gravitymir/drain_watcher/hardware/README.md

# drain_watcher: плата v3

Логгер тока утечки автомобильного аккумулятора: ESP32-S3 и INA228 на одной плате. Питается
от того же аккумулятора через понижающий преобразователь, Wi-Fi поднимает сама: история
замеров смотрится с телефона или ноутбука через веб-страницу, без проводов к машине.

Шунт стоит на силовых шинах в минусе аккумулятора, **основной ток по плате не идёт**: она
только снимает напряжение с шунта (четырёхпроводное подключение, Kelvin) и напряжение
аккумулятора.

| | |
|---|---|
| Размер | 52 × 41.2 мм, без крепёжных отверстий, 2 слоя, 1.6 мм, медь 1 oz |
| Контроллер | ESP32-S3-WROOM-1-N8R2 (металлический экран, до +85 °C), антенна у левого края |
| Измерение | INA228 (20 бит, смещение ±1 мкВ), I2C, адрес **0x40** (A0 = A1 = GND) |
| Звук | I2S-микрофон ICS-43434, моно |
| Питание | BAT+ 6…24 В (AP63205, 5 В) **или** USB-C 5 В; 3.3 В — TLV75733 |
| Проверки | DRC KiCad 10: 0 нарушений на всех уровнях, схема = плата; ERC: 0 сообщений |

## Провода J2 — к шунту и аккумулятору

Четыре отверстия 1.15 мм под провод до 0.5 мм², шаг 4.6 мм. Провода впаиваются наглухо.

| Контакт | Цепь | Куда |
|---|---|---|
| 1 `SNS+` | SNS_P | измерительный винт шунта со стороны **кузова** (отдельный тонкий провод) |
| 2 `SNS-` | SNS_N | измерительный винт шунта со стороны **аккумулятора** (отдельный тонкий провод) |
| 3 `GND` | GND | та же сторона шунта, что и SNS-, но **своим** проводом |
| 4 `BAT+` | VBAT | плюс аккумулятора через **предохранитель 1 А в самом проводе** |

SNS+ и SNS- скрутите в пару и заведите прямо на измерительные винты шунта. Положительный
ток означает разряд. BAT+ теперь и питает плату (ESP32 с Wi-Fi — в среднем ~40 мА от 12 В,
пики ~150 мА), и даёт INA228 напряжение аккумулятора.

## Выводы ESP32

| Сигнал | GPIO | Вывод модуля |
|---|---|---|
| I2C SDA (INA228) | IO13 | 21 |
| I2C SCL (INA228) | IO12 | 20 |
| ALERT INA228 | IO21 | 23 — подтяжки на плате нет, включите внутреннюю |
| RGB-светодиод WS2812B (DIN) | IO48 | 25 — как на DevKitC-1 |
| Кнопка BOOT | IO0 | 27 |
| USB D-/D+ | IO19/IO20 | 13/14 — встроенный USB Serial/JTAG: прошивка и логи |
| Микрофон I2S SD | IO47 | 24 — данные, подтяжка 100 кОм на землю (R12) на плате |
| Микрофон I2S WS | IO14 | 22 |
| Микрофон I2S SCK | IO11 | 19 |

Подтяжки I2C 4.7 кОм к 3.3 В стоят на плате.

### Микрофон

**MK1 — ICS-43434** (I2S MEMS, как в Voice-Unit) в середине верхней части, над INA228.
Развязка C11 100 нФ вплотную к выводу VDD. R12 100 кОм держит линию SD на земле, пока
микрофон её отпускает (так требует даташит).
Вывод L/R на земле — левый канал, моно. Звуковой порт у него снизу: под корпусом в плате
отверстие 0.5 мм, звук заходит с **обратной стороны** — в корпусе напротив него нужно
отверстие. В прошивке: I2S, 24 бита в 32-битном слове, левый канал, частота до 48 кГц.

### Ряд отверстий GPIO (J3, шаг 2.54 мм)

Над модулем, слева направо (подписи с обеих сторон):

`IO1 IO2 TX RX IO42 IO41 IO40 IO39 IO38 IO37 IO36 IO35 GND 3V3 5V`

Это все свободные выводы верхнего ряда модуля в том же порядке, что и у самого модуля.
IO35–IO37 свободны только у модулей **без восьмибитной PSRAM** (N8, N8R2). У N16R8 они
заняты памятью, поэтому такой модуль сюда не ставить. `5V` — общая шина после диодов
«ИЛИ» (~4.6 В), `3V3` — выход стабилизатора, от каждого можно взять до ~200 мА.

## Питание

```
BAT+ ─ D4 (B5819W) ─┬─ D5 SMF24A, C10 10 мкФ ─ U3 AP63205 ─ L1 4.7 мкГн ─ C13,C14 2×22 мкФ ─ D6 ─┐
                    (VIN, до 32 В)                                       (+5V_B)                ├─ +5V ─ U4 TLV75733 ─ +3V3
USB VBUS ────────────────────────────────────────────────────────────────────────── D7 ────────┘
```

- **D4** — защита от переполюсовки BAT+ (Шоттки, теряется ~0.4 В).
- **D5** — TVS 24 В от выбросов на входе. Машина при замерах не заводится, выше 14.4 В
  напряжение не поднимается, запас до предела AP63205 (32 В) большой.
- **D6, D7** — диоды «ИЛИ»: плата одинаково работает от аккумулятора, от USB или от
  обоих сразу, и USB-порт компьютера не получает напряжение с преобразователя.
- **USB-C** — для прошивки и логов. Подключённый к машине, компьютер оказывается
  соединённым с кузовом через GND. Ноутбук на батарее — нормально, компьютер от сети —
  нет (или через USB-изолятор).

## Шунт

Плата рассчитана на замеры **на заглушённой машине**: двигатель не запускается, машина не
едет. Тогда весь ток — это блоки, свет и вентиляторы, максимум ~20–25 А, с запасом **35 А**.

| | |
|---|---|
| Шунт | четырёхвыводной, **30 А / 75 мВ = 2.5 мОм** (например CG FL-2C 30A 75mV, класс 0.5) |
| Шкала | широкий диапазон ±163.84 мВ — до ~65 А; узкий ±40.96 мВ — до ~16 А с шагом ~31 мкА |
| Точность на утечке | ±0.4 мА по смещению INA228, после калибровки нуля — порядка ±0.05–0.1 мА |

**Запуск двигателя через шунт на 2.5 мОм недопустим**: 150–300 А его сожгут, а сгоревший в
обрыв шунт оставит машину без основной массы. Поставьте **параллельно шунту выключатель
массы** на 100–300 А: замкнут — шунт закорочен, машина ездит как обычно; разомкнут — идёт
замер.

## Измерение: два диапазона и калибровка

У INA228 полная шкала по шунту переключается битом **`ADCRANGE`** в регистре `CONFIG`.
Те же 20 бит ложатся на вчетверо меньший диапазон, то есть шаг становится вчетверо мельче:

| `ADCRANGE` | полная шкала | шаг по напряжению | на шунте 2.5 мОм |
|---|---|---|---|
| 0 — широкий | ±163.84 мВ | 312.5 нВ | до ±65 А, шаг 125 мкА |
| 1 — узкий | ±40.96 мВ | 78.125 нВ | до ±16 А, **шаг 31 мкА** |

Ток утечки — десятки миллиампер: 30 мА на 2.5 мОм дают 75 мкВ, то есть почти тысячу
отсчётов на узкой шкале и всего две с половиной сотни на широкой. Поэтому спящая машина
меряется узким диапазоном, а широкий нужен, только когда какой-то блок проснулся и утянул
больше ~16 А.

**При смене диапазона обязательно пересчитывается `SHUNT_CAL`.** Он считается как
`13107.2e6 × CURRENT_LSB × R_шунта`, и для узкого диапазона результат **умножается на 4**.
В драйвере [`firmware/ina228`](../firmware/ina228) диапазон меняется только через
`set_range`, который сразу переписывает и `SHUNT_CAL`, а `measure_autoranged` сам уходит в
широкую шкалу при переполнении узкой и возвращается, когда ток опустится ниже 80 % узкой.

**Параметры для прошивки:** `R_SHUNT = 0.0025` Ом, верх шкалы 35 А, отсюда
`CURRENT_LSB = 35 / 2¹⁹ ≈ 66.8 мкА`. Один раз — калибровка нуля (замкнуть SNS+ и SNS− и
запомнить смещение) и коэффициента (сверка с мультиметром или токовыми клещами). Делитель
VBUS занижает напряжение примерно на 1 % — тоже калибровочный коэффициент.

## Вход измерения

- **Ток**: TVS SMF24CA (двунаправленный) на проводах, затем по 10 Ом в каждую линию и
  100 нФ между входами у INA228 (как в TI, раздел 8.1).
- **Напряжение АКБ**: 10 кОм (1206) → SMF24A на землю + 100 нФ → VBUS INA228.
- **TVS на входе 24 В, а не ±5 В.** Входы INA228 выдерживают ±40 В дифференциально и
  85 В синфазно, ток в вывод — до 5 мА. TVS на 5 В при случайном касании SNS+ к +12 В
  открылся бы и замкнул аккумулятор через провод. SMF24CA при 12 В закрыт.
- **VBUS через 10 кОм** ограничивает ток при переполюсовке до 1.2 мА (меньше 5 мА).

## Заказ

JLCPCB, три файла из этой папки:

1. **`drain_watcher_gerbers.zip`** — плата. 2 слоя, FR-4, 1.6 мм, медь 1 oz, остальное по
   умолчанию. Дорожки от 0.15 мм (у падов USB-C — 0.13 мм), зазоры 0.2 мм, отверстия от 0.3 мм, via 0.6/0.3 — всё в
   стандартных нормах для двухслойки.
2. **`BOM.csv`** — 38 SMD-деталей, номера LCSC проставлены. ESP32-S3, INA228, AP63205,
   TLV75733, WS2812B, ICS-43434, B5819W, дроссель, USB-C, кнопки и TVS — Extended (разовая плата за
   установку каждой позиции), пассивка — Basic. **Наличие проверьте при заказе**: INA228
   сейчас в дефиците (см. ниже).
3. **`pos.csv`** — координаты для монтажа (только верхняя сторона).

В просмотрщике размещения у JLCPCB проверьте:
- **U1** (модуль) — антенна к левому краю платы, за контур;
- **U2, U3, U4** — точка/ключ первого вывода — как на шелкографии;
- **D4, D6, D7, D2, D5** — полоска катода как на шелкографии;
- **D3** (WS2812B) — скошенный угол/метка 1-го вывода как на шелкографии.

Поправки для JLCPCB уже внесены в `pos.csv` (`ROT_FIX` и `POS_FIX` в `gen/export.py`):
U2, U3, U4 и микрофон MK1 — +270°, у них корпус в библиотеке EasyEDA лежит поперёк; модуль U1 — +3.62 мм
по X, у EasyEDA начало координат модуля в центре падов; USB-C J1 — 1.57 мм по Y.
Проверка — `gen/jlc_check.py`: она скачивает посадочные места JLCPCB по номерам LCSC и
сравнивает их пады с нашими (`~` у кнопок, D1 и центрального пада модуля — норма).

J2 (провода) и J3 (ряд GPIO) — только отверстия: в BOM и CPL их нет.

**ICS-43434** (C5656610) снят с производства, остатки на складе небольшие. Если его не
окажется — «Do not place» и запаять руками (корпус LGA 3.5 × 2.65 мм, только феном).

**INA228** у JLCPCB/LCSC, DigiKey и Mouser сейчас нет (ожидается в 2027). Вариант —
выпаять из модулей Adafruit 5832 и поставить руками (MSOP-10), а в BOM исключить U2.
По выводам совместим INA226 (16 бит, шкала ±81.92 мВ) — подходит как временная замена.

## Сборка из скриптов

Плату не рисовали мышкой: схему, размещение, ручную разводку критичных цепей и шелк
описывает `gen/build.py`, остальное разводит Freerouting через `gen/route.py`, после чего
углы скругляются дугами. Нужен Python из KiCad 10, а для перетрассировки — Java 21+ и
[Freerouting 2.5](https://github.com/freerouting/freerouting/releases) (переменные
`JAVA` и `FREEROUTING_JAR`, по умолчанию `~/tools/jre/*/bin/java` и
`~/tools/freerouting/freerouting-2.5.0.jar`).

```bash
sh gen/check.sh
```

Скрипт пересобирает схему и плату, разводит её и прогоняет DRC KiCad с проверкой схемы
против платы, ERC, зазоры, связность, courtyard и шелк. Выходные файлы для заказа:

```bash
"/c/Program Files/KiCad/10.0/bin/python.exe" gen/outputs.py drain_watcher.kicad_pcb
"/c/Program Files/KiCad/10.0/bin/python.exe" gen/export.py .
```

### Как устроена разводка

- **Вручную** (`build.py`, заблокирована): Kelvin-пара от проводов через RC-фильтр к
  INA228, VBUS INA228, земля адреса, BAT+ → D4, via на землю у силовой части.
- **Freerouting** (`route.py`): всё остальное, только углы 45°, питание 0.4–0.5 мм, USB
  0.15 мм. У узких падов USB-C роутер сам сужает дорожку, `route.py` доводит такие места
  до 0.13 мм (норма JLCPCB для двухслойки — от 0.127). Результат (`drain_watcher.ses`) лежит в репозитории вместе с ключом
  (`.ses.key`). Пока не менялись детали, их места и ручная разводка, роутер не
  запускается, плата собирается из готового `.ses` одинаково. `--reroute` — развести
  заново.
- **Правило проекта** `drain_watcher.kicad_dru`: мелким земляным падам со своей
  дорожкой на via (адрес INA228, земля микрофона) хватает одной тепловой перемычки к
  заливке.
- **Дуги**: каждый излом заменяется дугой радиусом до 1 мм; если дуга подошла к
  соседу ближе зазора, она откатывается обратно в излом.
- Freerouting от раза к разу разводит по-разному. Если DRC KiCad результат не
  пропускает, `route.py` разводит заново (до 8 попыток).

Версии без контроллера (модуль INA228 под внешний ESP32) и прошлые варианты с ESP32
остались в истории git.
