gravitymir/drain_watcher/hardware/bot.pdf

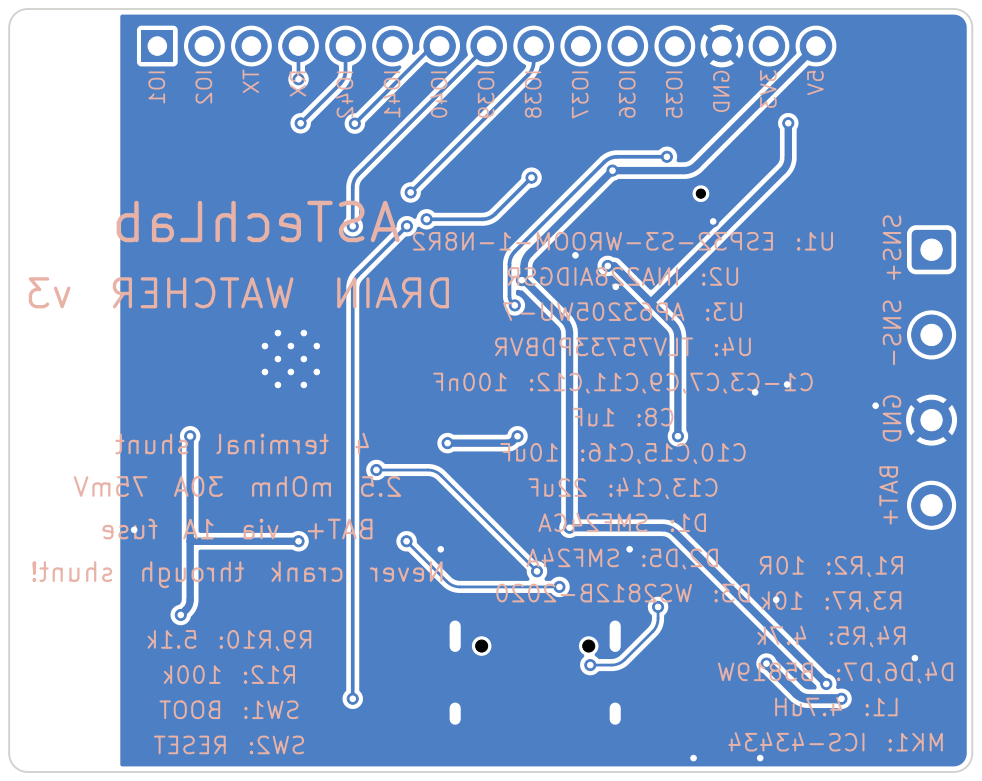
[picture p1: page 1]

IO1 IO2 TXRXIO42 IO41 IO40 IO39 IO38 IO37 IO36 IO35 GND 3V3 5V 5.1k R9,R10: 100k R12: BOOT SW1: RESET SW2: ESP32-S3-WROOM-1-N8R2 U1:

ICS-43434 MK1: BAT+ SNS+ SNS- GND

fuse 1A via BAT+ shunt! through crank Never v3 WATCHER DRAIN
