gravitymir/drain_watcher/hardware/sch.pdf

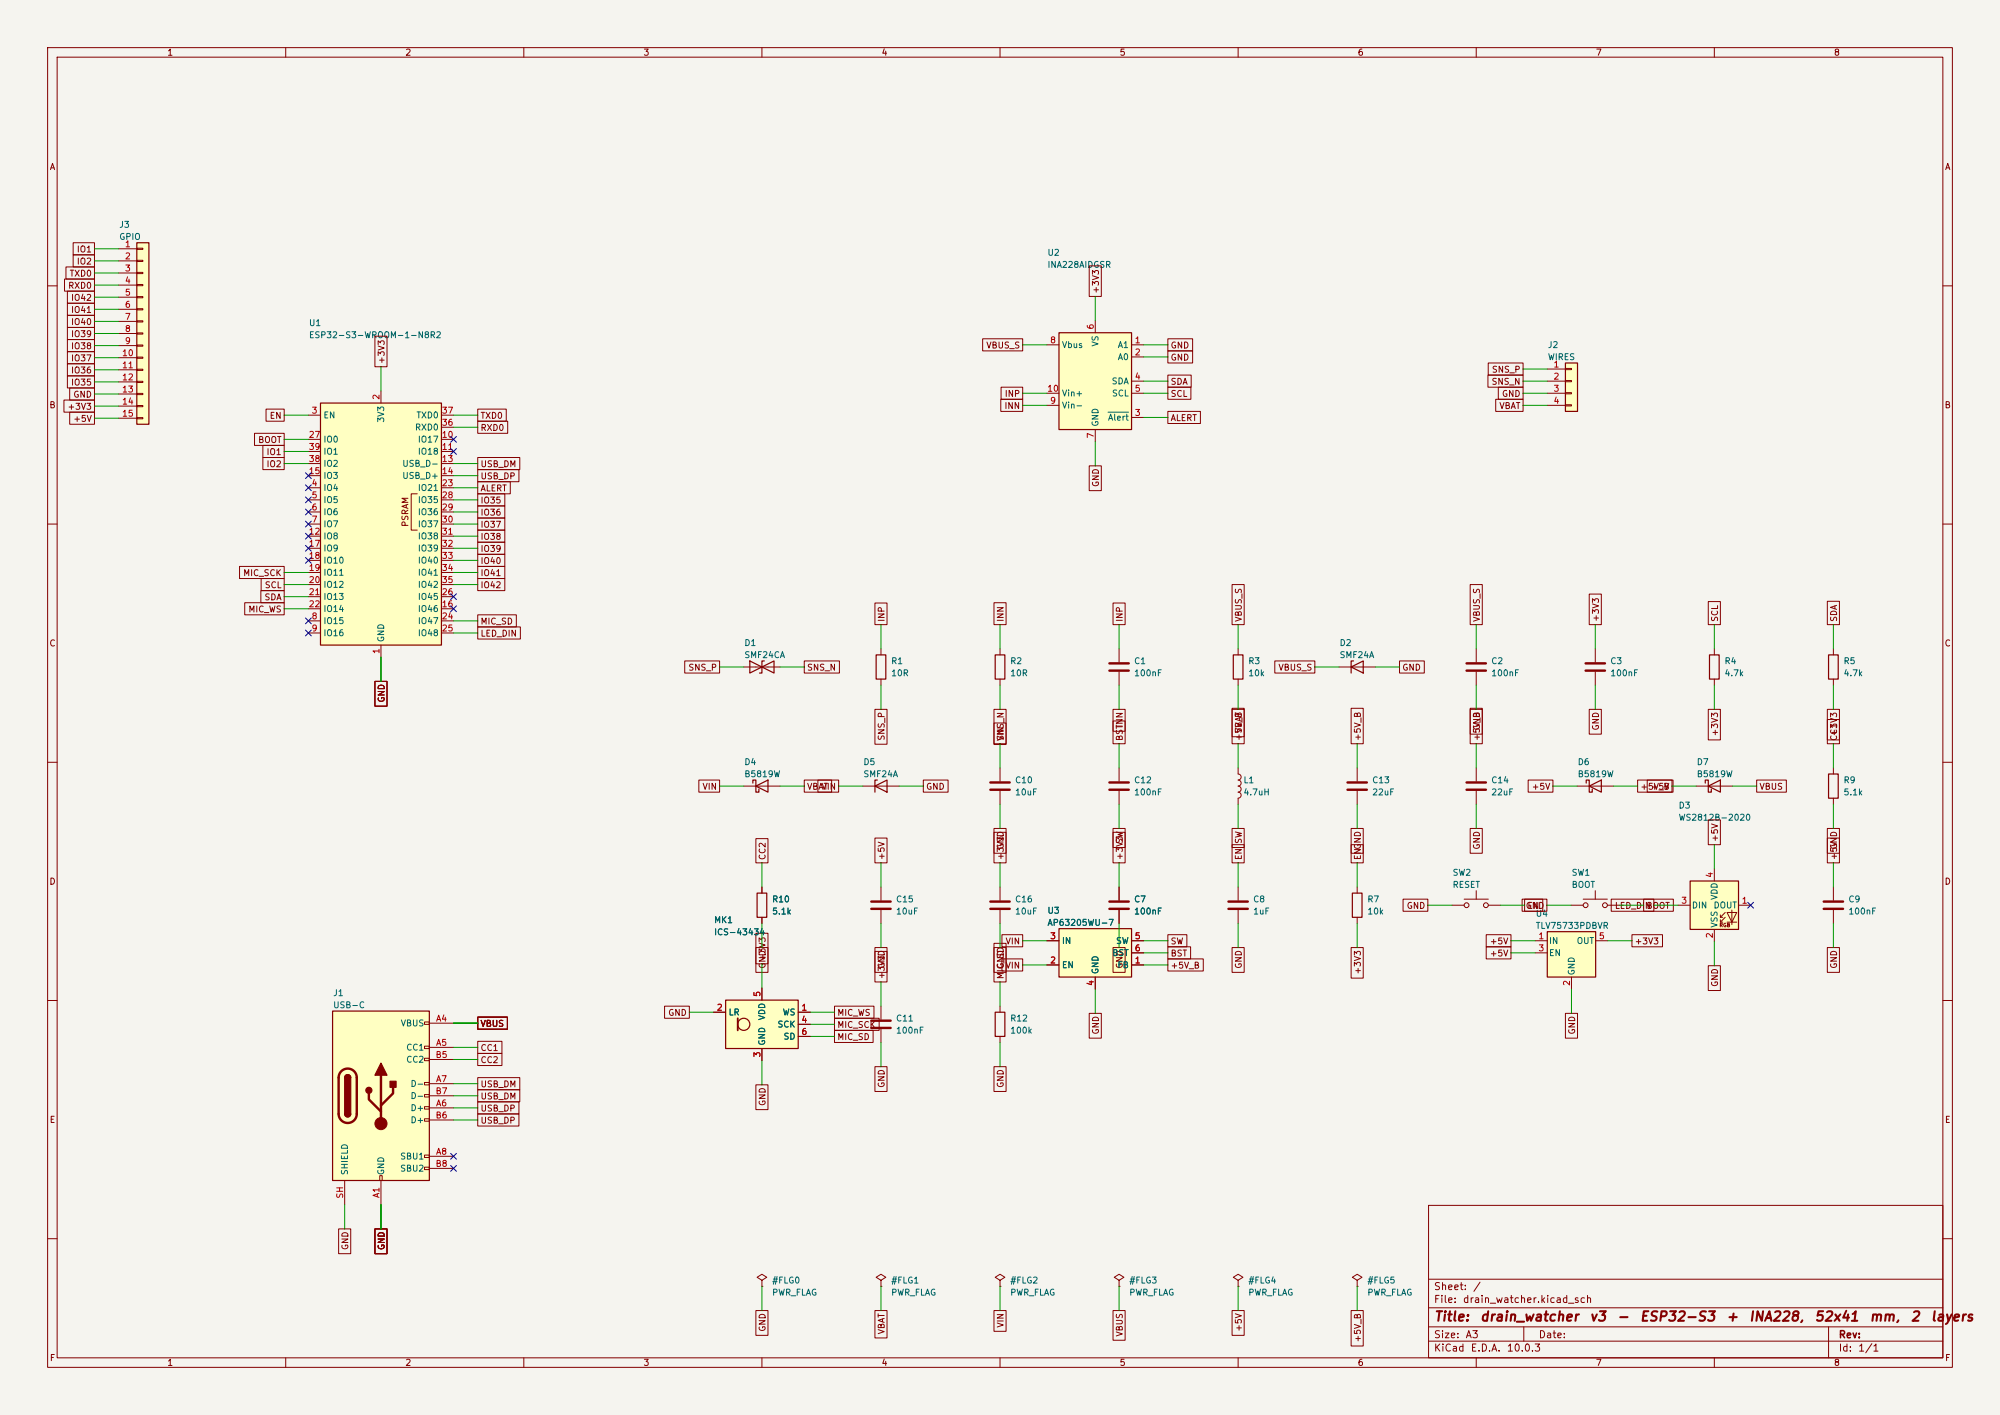
[picture p2: page 1]

Size: A3 | Rev: | F Date:
KiCad E.D.A. 10.0.3 | Id: 1/1
