gravitymir/drain_watcher/hardware/top.pdf

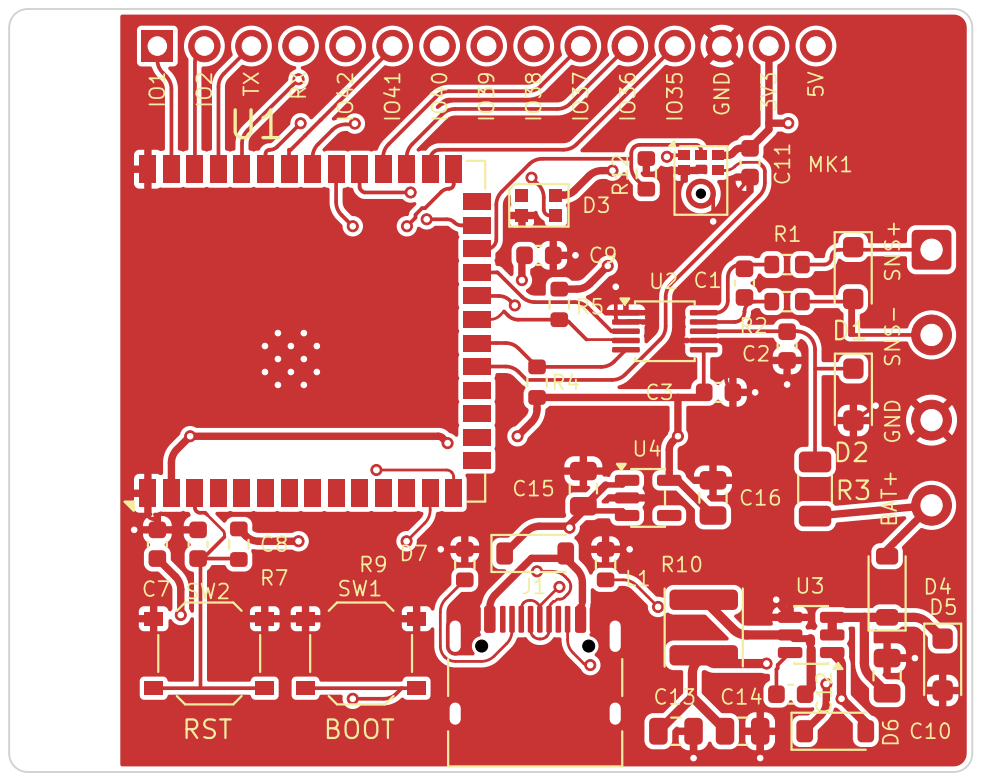
[picture p3: page 1]

IO1 IO2TXRX IO42 IO41 IO40 IO39 IO38 IO37 IO36 IO35 GND 3V35V BAT+ SNS+ SNS- GND RST BOOT U2 D3 C8 R2 R9 R7 D4 C14 D5 C15 R12
