gravitymir/drain_watcher/hardware/drain_watcher.kicad_pcb

## KiCad design hardware/drain_watcher.kicad_pcb (2026-11-14)

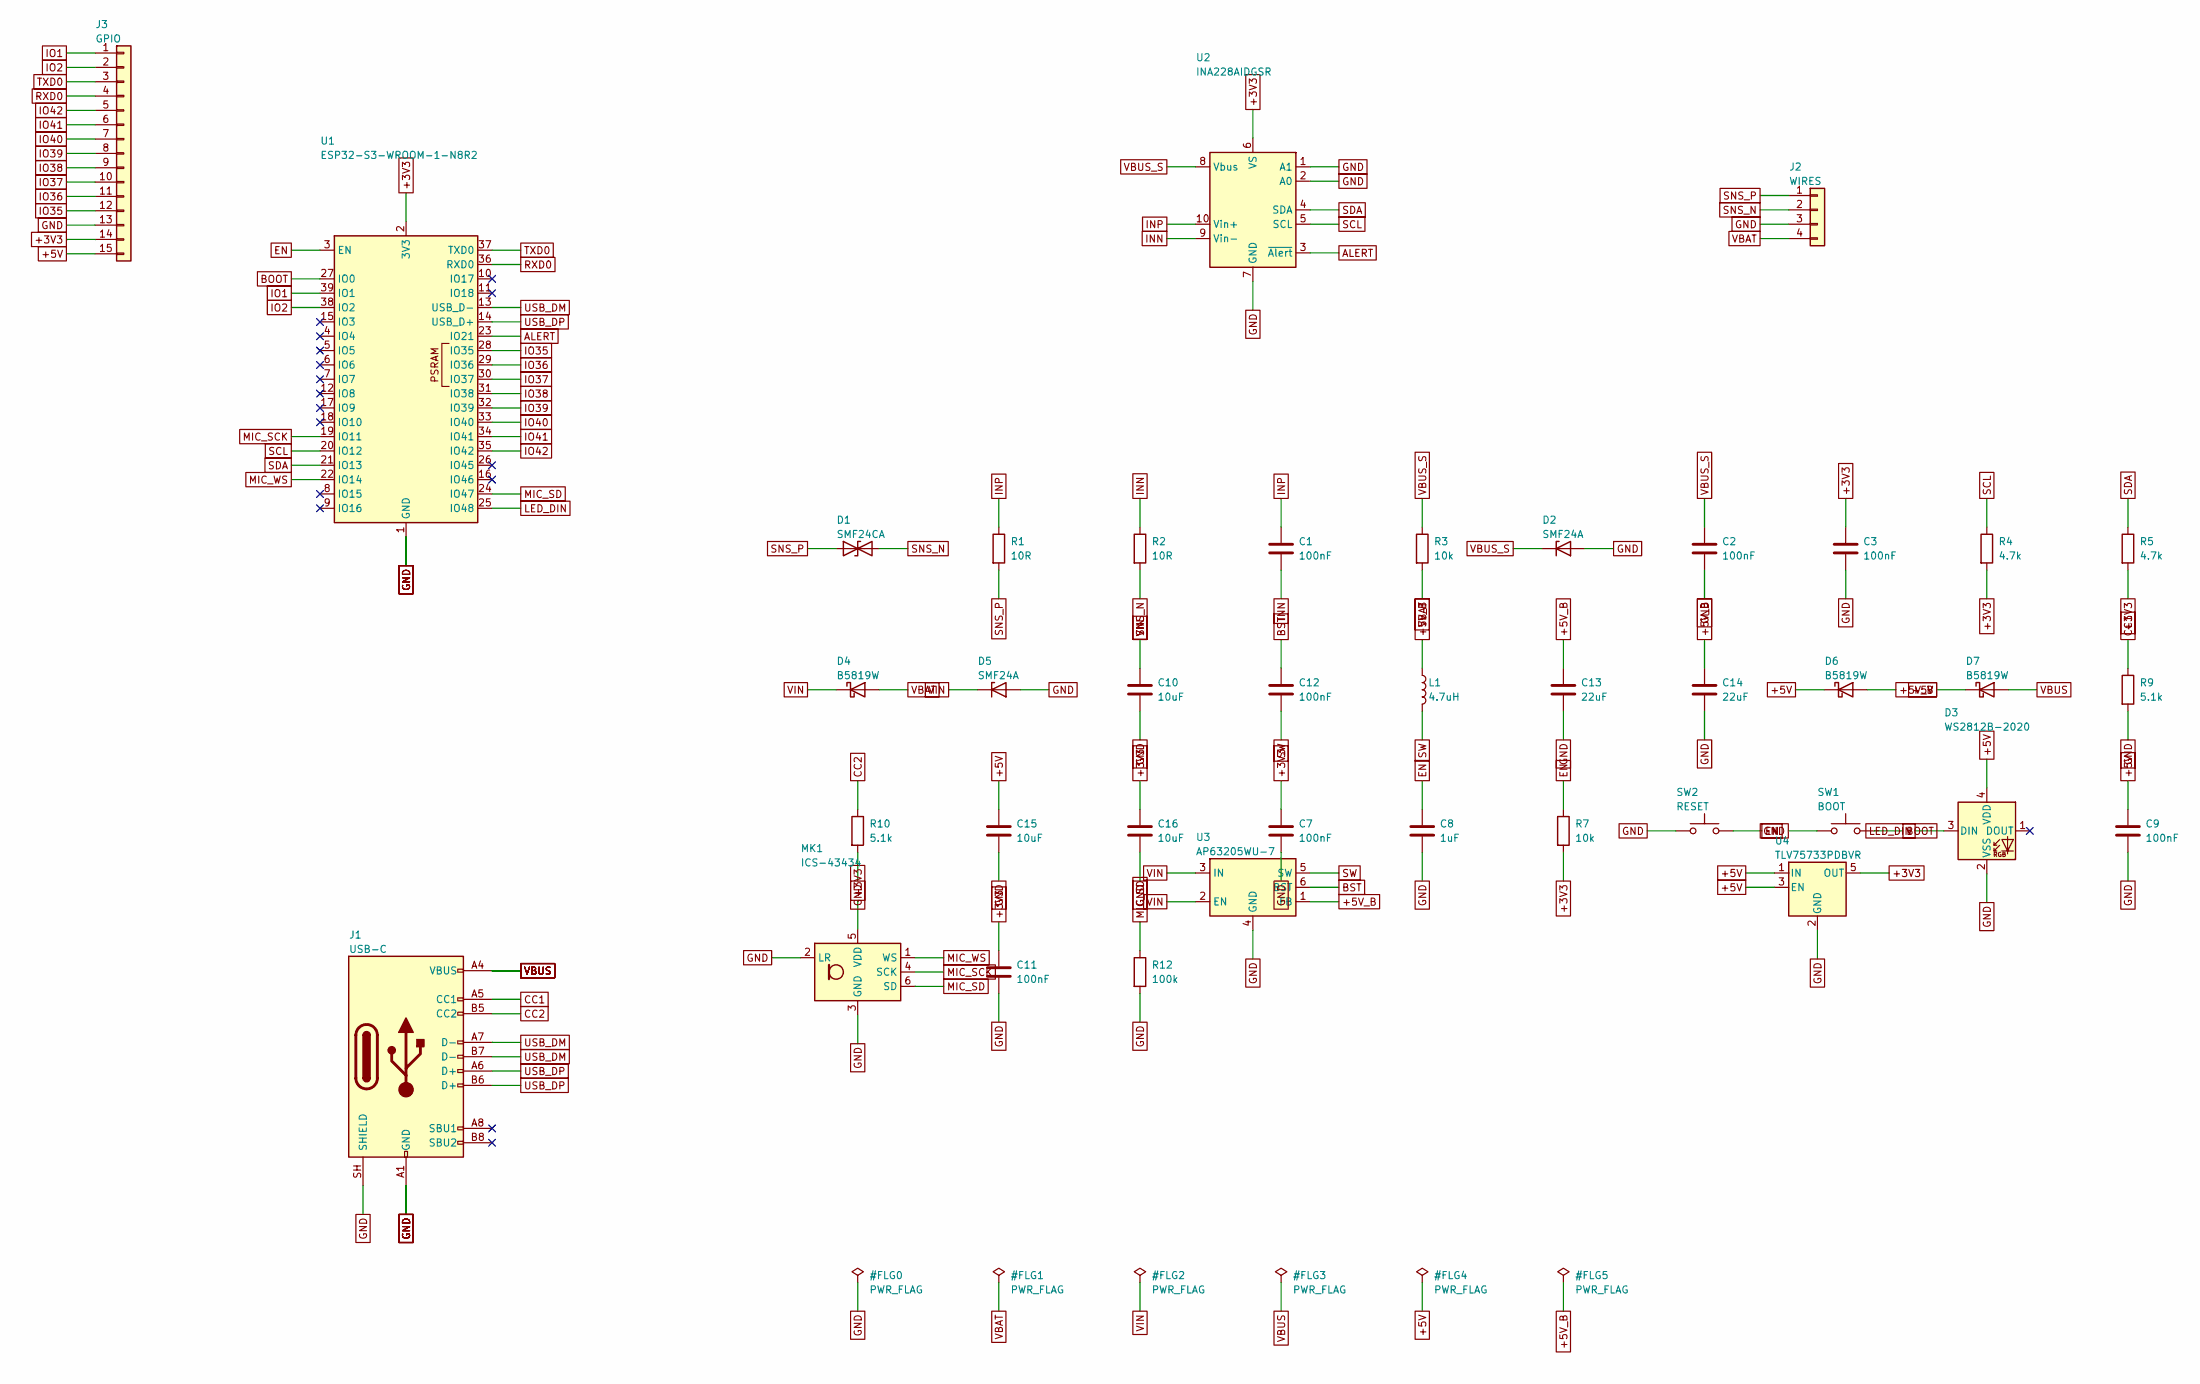
[picture p4: schematic drain_watcher.kicad_sch, drain_watcher v3 - ESP32-S3 + INA228, 52x41 mm, 2 layers]

Parts:
C1, C2, C3, C7, C9, C11, C12: 100nF; C_0603_1608Metric
C8: 1uF; C_0603_1608Metric
C10, C15, C16: 10uF; C_0805_2012Metric
C13, C14: 22uF; C_0805_2012Metric
D1: SMF24CA; D_SOD-123F
D2, D5: SMF24A; D_SOD-123F
D3: WS2812B-2020; LED_WS2812B-2020_PLCC4_2.0x2.0mm
D4, D6, D7: B5819W; D_SOD-123
J1: USB-C; USB_C_Receptacle_HRO_TYPE-C-31-M-12
J2: WIRES; SolderWire-0.5sqmm_1x04_P4.6mm_D0.9mm_OD2.1mm
J3: GPIO; PinHeader_1x15_P2.54mm_Vertical
L1: 4.7uH; L_Sunlord_SWPA4030S
MK1: ICS-43434; InvenSense_ICS-43434-6_3.5x2.65mm
R1, R2: 10R; R_0603_1608Metric
R3: 10k; R_1206_3216Metric
R4, R5: 4.7k; R_0603_1608Metric
R7: 10k; R_0603_1608Metric
R9, R10: 5.1k; R_0603_1608Metric
R12: 100k; R_0603_1608Metric
SW1: BOOT; SW_Push_1P1T_XKB_TS-1187A
SW2: RESET; SW_Push_1P1T_XKB_TS-1187A
U1: ESP32-S3-WROOM-1-N8R2; ESP32-S3-WROOM-1
U2: INA228AIDGSR; MSOP-10_3x3mm_P0.5mm
U3: AP63205WU-7; TSOT-23-6
U4: TLV75733PDBVR; SOT-23-5

Connections:
+3V3: C3.1, C7.1, C11.1, C16.1, J3.14, MK1.5 (VDD), R4.2, R5.2, R7.2, U1.2 (3V3), U2.6 (VS), U4.5 (OUT)
+5V: C9.1, C15.1, D3.4 (VDD), D6.1 (K), D7.1 (K), J3.15, U4.1 (IN), U4.3 (EN)
+5V_B: C13.1, C14.1, D6.2 (A), L1.1, U3.1 (FB)
ALERT: U1.23 (IO21), U2.3 (~Alert)
BOOT: SW1.2, U1.27 (IO0)
BST: C12.1, U3.6 (BST)
CC1: J1.A5 (CC1), R9.1
CC2: J1.B5 (CC2), R10.1
EN: C8.1, R7.1, SW2.2, U1.3 (EN)
GND: C2.2, C3.2, C7.2, C8.2, C9.2, C10.2, C11.2, C13.2, C14.2, C15.2, C16.2, D2.2 (A), D3.2 (VSS), D5.2 (A), J1.A1 (GND), J1.A12 (GND), J1.B1 (GND), J1.B12 (GND), J1.SH (SHIELD), J2.3, J3.13, MK1.2 (LR), MK1.3 (GND), R9.2, R10.2, R12.2, SW1.1, SW2.1, U1.1 (GND), U1.40 (GND), U1.41 (GND), U2.1 (A1), U2.2 (A0), U2.7 (GND), U3.4 (GND), U4.2 (GND)
INN: C1.2, R2.1, U2.9 (Vin-)
INP: C1.1, R1.1, U2.10 (Vin+)
IO1: J3.1, U1.39 (IO1)
IO2: J3.2, U1.38 (IO2)
IO35: J3.12, U1.28 (IO35)
IO36: J3.11, U1.29 (IO36)
IO37: J3.10, U1.30 (IO37)
IO38: J3.9, U1.31 (IO38)
IO39: J3.8, U1.32 (IO39)
IO40: J3.7, U1.33 (IO40)
IO41: J3.6, U1.34 (IO41)
IO42: J3.5, U1.35 (IO42)
LED_DIN: D3.3 (DIN), U1.25 (IO48)
MIC_SCK: MK1.4 (SCK), U1.19 (IO11)
MIC_SD: MK1.6 (SD), R12.1, U1.24 (IO47)
MIC_WS: MK1.1 (WS), U1.22 (IO14)
RXD0: J3.4, U1.36 (RXD0)
SCL: R4.1, U1.20 (IO12), U2.5 (SCL)
SDA: R5.1, U1.21 (IO13), U2.4 (SDA)
SNS_N: D1.2 (A2), J2.2, R2.2
SNS_P: D1.1 (A1), J2.1, R1.2
SW: C12.2, L1.2, U3.5 (SW)
TXD0: J3.3, U1.37 (TXD0)
USB_DM: J1.A7 (D-), J1.B7 (D-), U1.13 (USB_D-)
USB_DP: J1.A6 (D+), J1.B6 (D+), U1.14 (USB_D+)
VBAT: D4.2 (A), J2.4, R3.2
VBUS: D7.2 (A), J1.A4 (VBUS), J1.A9 (VBUS), J1.B4 (VBUS), J1.B9 (VBUS)
VBUS_S: C2.1, D2.1 (K), R3.1, U2.8 (Vbus)
VIN: C10.1, D4.1 (K), D5.1 (K), U3.2 (EN), U3.3 (IN)

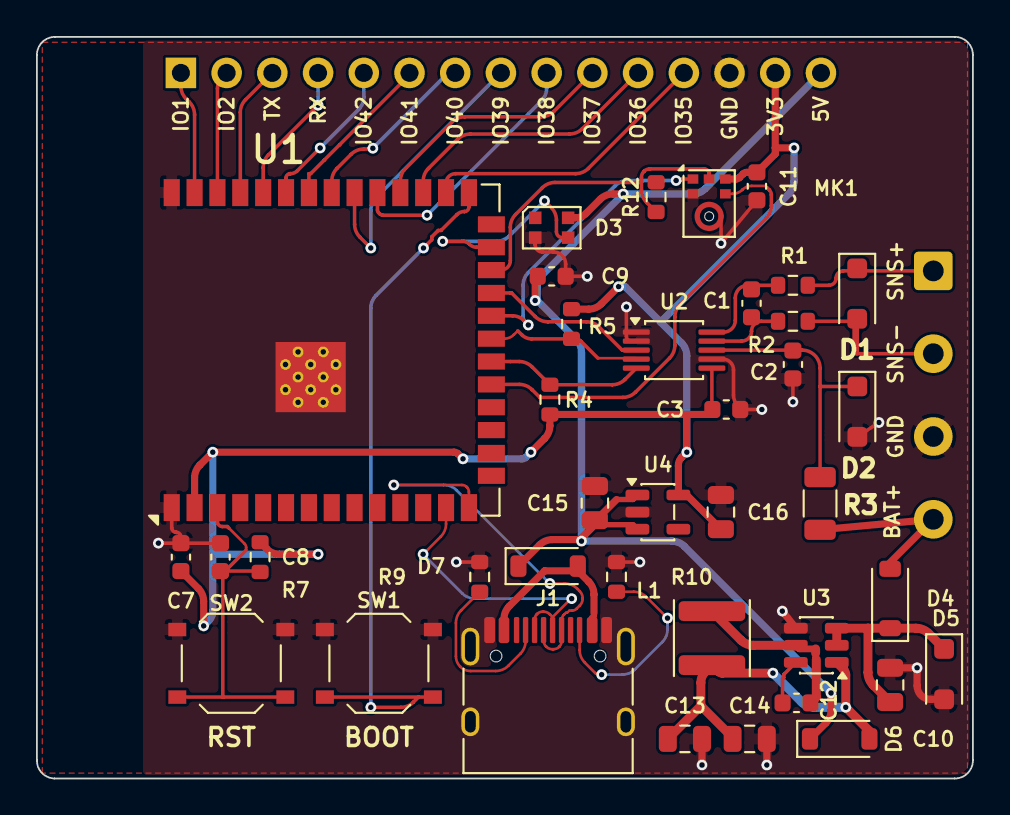
[picture p5: board drain_watcher.kicad_pcb from above]

Board: 2 copper layers, 52.0 x 41.2 mm, 40 parts (0 on the bottom side), 39 nets.
