gravitymir/drain_watcher/(commit log)

2026-11-10 Плата drain_watcher: INA228 + ESP32-S3, 70x50 мм, 2 слоя
    Схема, размещение и разводка собираются скриптом hardware/gen/build.py
    (генератор из auto_probe). Шунт вне платы, питание от пауэрбанка через USB-C.
    DRC KiCad 10 - 0 нарушений, схема совпадает с платой, ERC - 0 ошибок.
    Гербера, BOM и CPL в формате JLCPCB с номерами LCSC.
    [BOM.csv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]
2026-11-10 Плата-датчик INA228 без контроллера: 28 x 18.3 мм, шунт 30A/75mV
    ESP32-S3, USB-C, стабилизатор и кнопки убраны: внешний контроллер
    подключается к J1 по I2C (VCC, GND, SCL, SDA, ALERT) с подтяжками на
    плате. Клемма заменена отверстиями под провода, крепёжные отверстия
    убраны, контур обрезан по деталям. Шелкография - по ручной расстановке
    в KiCad, легенда номиналов на обороте.
    Плата рассчитана на замеры на заглушённой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
    [BOM.csv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]
2026-11-10 Шелкография: подписи гребёнки и обозначения крупнее, надпись про шунт в три строки
    Подписи J1 на обороте и обозначения D1, D2, R3, J1 - шрифт 1.0 / 0.25,
    надпись о шунте на лицевой стороне - 2.5 mOhm / 30A 75mV, три строки.
    Положения перенесены из ручной расстановки в KiCad в build.py.
    DRC - 0 нарушений, схема = плата, ERC - 0 ошибок; гербера пересобраны.
    [drain_watcher-B_Cu.gbl, drain_watcher-B_Mask.gbs, drain_watcher-B_Paste.gbp, drain_watcher-B_Silkscreen.gbo, drain_watcher-Edge_Cuts.gm1, drain_watcher-F_Cu.gtl, drain_watcher-F_Mask.gts, drain_watcher-F_Paste.gtp]
2026-11-11 INA228: земля адресных выводов - via над корпусом, а не под ним
    Выводы 1 и 2 (A1, A0 -> GND) сведены вертикалью у внешних концов падов
    и выведены вверх мимо корпуса к via над микросхемой: отверстие видно и
    доступно щупу. DRC - 0 нарушений, гербера пересобраны.
    [drain_watcher-B_Cu.gbl, drain_watcher-B_Mask.gbs, drain_watcher-B_Paste.gbp, drain_watcher-B_Silkscreen.gbo, drain_watcher-Edge_Cuts.gm1, drain_watcher-F_Cu.gtl, drain_watcher-F_Mask.gts, drain_watcher-F_Paste.gtp]
2026-11-11 Драйвер INA228 на Rust и описание двух диапазонов шунта
    У INA228 полная шкала по шунту переключается битом ADCRANGE: те же 20 бит
    ложатся либо на +-163.84 мВ с шагом 312.5 нВ, либо на +-40.96 мВ с шагом
    78.125 нВ. Для тока утечки это главный рычаг - 30 мА на шунте 2.5 мОм дают
    75 мкВ, то есть почти тысячу отсчётов на узкой шкале против двухсот пятидесяти
    на широкой.
    Опасность в том, что SHUNT_CAL зависит от диапазона: для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
2026-11-14 Плата v3: ESP32-S3 + INA228 на одной плате, разводка Freerouting с дугами
    - ESP32-S3-WROOM-1-N8R2, антенна у левого края; USB-C для прошивки и логов
    - питание от аккумулятора: B5819W -> TVS -> AP63205 (5 В), USB через свой диод "ИЛИ",
    TLV75733 -> 3.3 В
    - ряд отверстий под свободные GPIO, WS2812B-2020 на IO48, кнопки RESET и BOOT
    - узел INA228 и провода к шунту - как на модуле INA228
    - gen/route.py: Freerouting (углы 45), чистка хвостов, скругление изломов дугами,
    повтор при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
    [BOM.csv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]
2026-11-14 CPL для JLCPCB: поправки положения и поворота по их посадочным местам
    - U2, U3, U4: +270 (в EasyEDA корпус лежит поперёк)
    - U1 (ESP32-S3): +3.62 мм по X - у EasyEDA начало координат в центре падов
    - J1 (USB-C): 1.57 мм по Y
    - POS_FIX в gen/export.py, проверка - gen/jlc_check.py
    - обозначение U1 - на месте, выставленном вручную в KiCad
    [drain_watcher-B_Cu.gbl, drain_watcher-B_Mask.gbs, drain_watcher-B_Paste.gbp, drain_watcher-B_Silkscreen.gbo, drain_watcher-Edge_Cuts.gm1, drain_watcher-F_Cu.gtl, drain_watcher-F_Mask.gts, drain_watcher-F_Paste.gtp]
2026-11-14 Микрофон I2S ICS-43434 в верхнем правом углу (моно)
    - MK1 ICS-43434 + C11 100 нФ: SD -> IO47, WS -> IO14, SCK -> IO11, L/R на GND
    - звуковое отверстие 0.5 мм в посадочном месте, звук с обратной стороны
    - drain_watcher.kicad_dru: мелким земляным падам со своей via хватает одной перемычки
    - легенда на обороте: шрифт 0.9, номера диапазонами, остаток блоками по 3 строки
    - CPL: MK1 +270 (сверено с посадочным местом JLCPCB), LCSC C5656610
    - разводка Freerouting пересч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
    [BOM.csv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]
2026-11-14 Микрофон на новом месте, R12 100k на SD, C11 у вывода VDD
    - MK1 - в середине верхней части (место выставлено вручную в KiCad)
    - C11 100 нФ вплотную к VDD микрофона, R12 100 кОм SD -> GND по даташиту
    - разводка пересчитана; сужения у падов USB-C доводятся до 0.13 мм (норма JLCPCB от 0.127)
    - исправлен синтаксис правила одной тепловой перемычки в .kicad_dru
    - легенда на обороте: остаток одним последним блоком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
    [BOM.csv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]
